asieldev/Fuzzy_Logic_Project/Prototipo.png

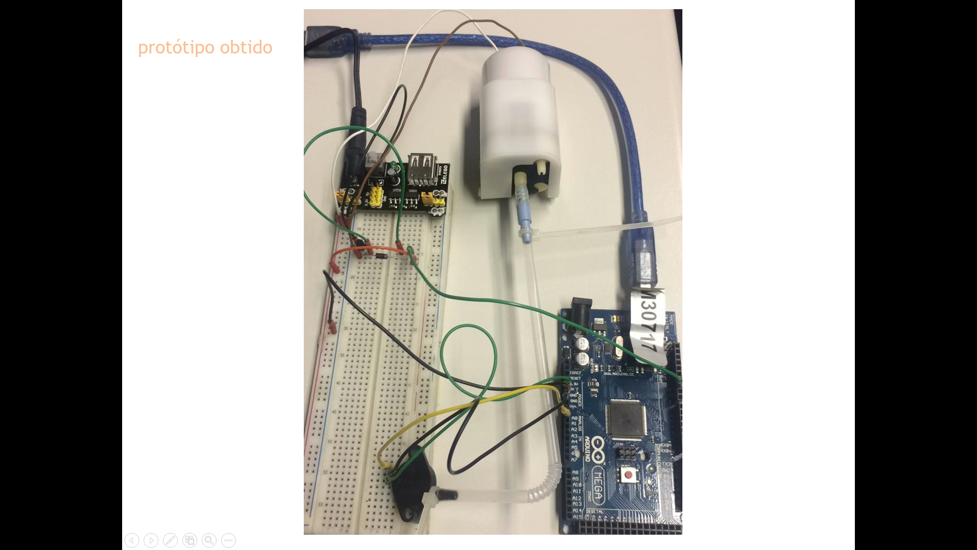
Prototipo.png
