asieldev/Fuzzy_Logic_Project/Code_Arduino/Proto.jpeg

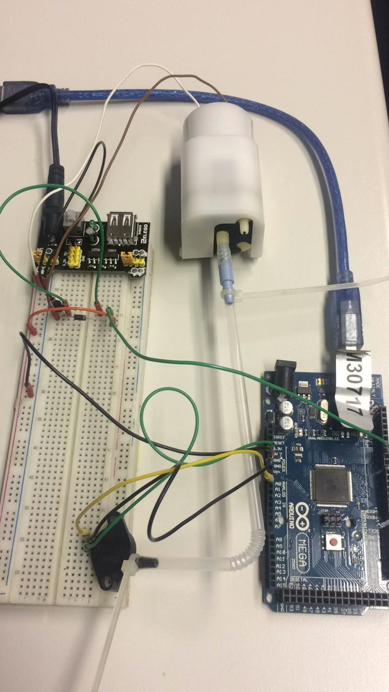
Code_Arduino/Proto.jpeg
