asieldev/Fuzzy_Logic_Project/README.md

# FuzzyLogic_Project
###  por Asiel Aldana Ortiz 

Este trabalho apresenta um controlador fuzzy capaz de realizar a inflação automática de uma faixa elástica que permita alcançar os níveis de pressão de referência com o menor erro de convergência possível, além de garantir que os tempos de convergência estejam dentro da faixa permitida pelos padrões internacionais para dispositivos médicos comerciais que empregam método oscilométrico para medição não invasiva da pressão arterial, Além de a implentação do controlador fuzzy no microcontrolador ATmega2560, foi desenvolvido uma  interface gráfica do usuário (GUI em Delphi_10.3_Rio) para assegurar o controle e visualização do sinal de pressão obtida da leitura do canal de medição analógico do microcontrolador antes mencionado. A sinal analógica de pressão é medida pelo sensor de pressão MPX5050GP. O modelo fuzzy gera em sua saída um valor preciso proporcional à largura do pulso com o qual a micro-Pump de ar será excitada para obter o nível de pressão desejado na saída.
