asieldev/Fuzzy_Logic_Project/Code_Arduino/Fuzzy_FILE_Asiel.rtf

General Information

Audit Log
2019-07-07 12:55:45 | asiel | 8.21c | FT 10005 28 HS | Last Edit
2019-07-02 02:20:31 | asiel | 8.21c | FT 10005 28 HS | Created

Documentation Created: domingo, 7 de julho de 2019
Edition Name: fuzzyTECH 8.21c Professional Edition
Table of Contents

List of Figures

List of Tables

List of Abbreviations

Compute MBF | Compute Membership Function (Fuzzification Method)
Fast CoA | Fast Center of Area (Defuzzification Method)
BSum | Bounded Sum Fuzzy Operator for Result Aggregation
Min | Fuzzy Operator for AND Aggregation
Max | Fuzzy Operator for OR Aggregation
Prod | Fuzzy Operator for Composition
LV | Linguistic Variable
MBF | Membership Function
RB | Rule Block

Fuzzy System

Project Description

Input Variables | 2
Output Variables | 1
Intermediate Variables | 0
Rule Blocks | 1
Rules | 15
Membership Functions | 12
Table 1: Project Statistics

System Structure

The system structure identifies the fuzzy logic inference flow from the input variables to the output variables. The fuzzification in the input interfaces translates analog inputs into fuzzy values. The fuzzy inference takes place in rule blocks which contain the linguistic control rules. The output of these rule blocks are linguistic variables. The defuzzification in the output interfaces translates them into analog variables.

The following figure shows the whole structure of this fuzzy system including input interfaces, rule blocks and output interfaces. The connecting lines symbolize the data flow.

Figure 1: Structure of the Fuzzy Logic System

Variables

This chapter contains the definition of all linguistic variables and of all membership functions.
Linguistic variables are used to translate real values into linguistic values. The possible values of a linguistic variable are not numbers but so called 'linguistic terms'.

The following tables list all variables of the system as well as the respective fuzzification or defuzzification method. Also the properties of all base variables and the term names are listed.

Inputs

# | Variable Name | Type | Unit | Min | Max | Default

1 | d_error | | | -1 | 1 | 0
2 | error | | | -300 | 300 | 0
Table 2: Variables of Group "Inputs"

Fuzzification Methods
Compute MBF

Outputs

# | Variable Name | Type | Unit | Min | Max | Default

3 | pwm_out | | | 0 | 255 | 0
Table 3: Variables of Group "Outputs"

Defuzzification Methods
Fast CoA

The default value of an output variable is used if no rule is firing for this variable. Different methods can be used for the defuzzification, resulting either in to the 'most plausible result' or the 'best compromise'.

The 'best compromise' is produced by the methods:
CoM (Center of Maximum)
CoA (Center of Area)
CoA BSUM, a version especially for efficient VLSI implementations

The 'most plausible result' is produced by the methods:
MoM (Mean of Maximum)
Categorical MoM (Categorical Mean of Maximum)
MoM BSUM, a version especially for efficient VLSI implementations

Input Variable "d_error"

Figure 2: MBF of "d_error"

Terms of Variable "d_error"

Term "d_neg"

Type: | Linear (Standard)
Definition Points: | (-1,00000|100) (-0,80000|100) (0,00000|0) (1,00000|0)
Inverse: | Off
Comment:

Term "d_ok"

Type: | Linear (Standard)
Definition Points: | (-1,00000|0) (-0,30000|0) (0,00000|100) (0,30000|0) (1,00000|0)
Inverse: | Off
Comment:

Term "d_pos"

Type: | Linear (Standard)
Definition Points: | (-1,00000|0) (0,00000|0) (0,80000|100) (1,00000|100)
Inverse: | Off
Comment:

Input Variable "error"

Figure 3: MBF of "error"

Terms of Variable "error"

Term "alto_neg"

Type: | Linear (Standard)
Definition Points: | (-300,00|100) (-250,00|100) (-50,00|0) (0,00|0) (300,00|0)
Inverse: | Off
Comment:

Term "medio_neg"

Type: | Linear (Standard)
Definition Points: | (-300,00|0) (-100,00|0) (-50,00|100) (0,00|0) (300,00|0)
Inverse: | Off
Comment:

Term "ok"

Type: | Linear (Standard)
Definition Points: | (-300,00|0) (-50,00|0) (0,00|100) (50,00|0) (300,00|0)
Inverse: | Off
Comment:

Term "medio_pos"

Type: | Linear (Standard)
Definition Points: | (-300,00|0) (0,00|0) (50,00|100) (100,00|0) (300,00|0)
Inverse: | Off
Comment:

Term "alto_pos"

Type: | Linear (Standard)
Definition Points: | (-300,00|0) (0,00|0) (50,00|0) (250,00|100) (300,00|100)
Inverse: | Off
Comment:

Output Variable "pwm_out"

Figure 4: MBF of "pwm_out"

Terms of Variable "pwm_out"

Term "pwm_zero"

Type: | Linear (Standard)
Definition Points: | (0,000|100) (2,000|100) (40,000|0) (255,000|0)
Comment:

Term "pwm_bajo"

Type: | Linear (Standard)
Definition Points: | (0,000|0) (20,000|0) (60,000|100) (100,000|0) (255,000|0)
Comment:

Term "pwm_medio"

Type: | Linear (Standard)
Definition Points: | (0,000|0) (80,000|0) (120,000|100) (160,000|0) (255,000|0)
Comment:

Term "pwm_alto"

Type: | Linear (Standard)
Definition Points: | (0,000|0) (140,000|0) (200,000|100) (255,000|100)
Comment:

Rule Blocks

The rule blocks contain the control strategy of a fuzzy logic system. Each rule block confines all rules for the same context. A context is defined by the same input and output variables of the rules.

The rules' 'if' part describes the situation, for which the rules are designed. The 'then' part describes the response of the fuzzy system in this situation. The degree of support (DoS) is used to weigh each rule according to its importance.

The processing of the rules starts with calculating the 'if' part. The operator type of the rule block determines which method is used. The operator types MIN-MAX, MIN-AVG and GAMMA are available. The characteristic of each operator type is influenced by an additional parameter.

For example:

MIN-MAX, parameter value 0 = Minimum Operator (MIN)
MIN-MAX, parameter value 1 = Maximum Operator (MAX)
GAMMA, parameter value 0 = Product Operator (PROD)

The minimum operator is a generalization of the Boolean 'and'; the maximum operator is a generalization of the Boolean 'or'.

The fuzzy composition eventually combines the different rules to one conclusion. If the BSUM method is used all firing rules are evaluated, if the MAX method is used only the dominant rules are evaluated.

Rule Block "RB1"

Input Aggregation: | Min
Result Aggregation: | Max
Number of Inputs: | 2
Number of Outputs: | 1
Number of Rules: | 15
Comment:
Color: | Default
Deactivation: | Off
Protection: | Off
GUID: | 7DEE4B1E-A46E-435F-AA06-B56DF9874BF9

Rule Group

Number of Rules: | 15
Comment:
Color: | Default
Deactivation: | Off
Protection: | Off
GUID: | 1B8908AF-63B8-464C-A887-546C7D04ABD9

Rule

Number of Rules: | 1
Comment:
Color: | Default
Deactivation: | Off
Protection: | Off
GUID: | 0E535615-8ACA-4875-BA54-561ACF44E7B4

d_error.d_ok & error.ok => pwm_out.pwm_zero with 100

Rule

Number of Rules: | 1
Comment:
Color: | Default
Deactivation: | Off
Protection: | Off
GUID: | BF0BCF48-3399-4D9F-96B7-05E60D73EF93

d_error.d_pos & error.ok => pwm_out.pwm_bajo with 100

Rule

Number of Rules: | 1
Comment:
Color: | Default
Deactivation: | Off
Protection: | Off
GUID: | 3FFBBA6A-C12C-41D0-923B-F194D03C67F6

d_error.d_neg & error.ok => pwm_out.pwm_bajo with 100

Rule

Number of Rules: | 1
Comment:
Color: | Default
Deactivation: | Off
Protection: | Off
GUID: | E0B96919-ADC3-433D-B43C-645749595862

d_error.d_ok & error.medio_pos => pwm_out.pwm_medio with 100

Rule

Number of Rules: | 1
Comment:
Color: | Default
Deactivation: | Off
Protection: | Off
GUID: | D77FE709-A8C2-412C-A9E2-85DFACECDE9A

d_error.d_pos & error.medio_pos => pwm_out.pwm_medio with 100

Rule

Number of Rules: | 1
Comment:
Color: | Default
Deactivation: | Off
Protection: | Off
GUID: | 9F48C289-89DC-496A-AED7-43C349745349

d_error.d_neg & error.medio_pos => pwm_out.pwm_medio with 100

Rule

Number of Rules: | 1
Comment:
Color: | Default
Deactivation: | Off
Protection: | Off
GUID: | 996EB08F-320E-4774-A6EF-AF46B29F5181

d_error.d_ok & error.alto_pos => pwm_out.pwm_alto with 100

Rule

Number of Rules: | 1
Comment:
Color: | Default
Deactivation: | Off
Protection: | Off
GUID: | 3CD51256-67CC-4600-ACCE-0580F2098630

d_error.d_pos & error.alto_pos => pwm_out.pwm_alto with 100

Rule

Number of Rules: | 1
Comment:
Color: | Default
Deactivation: | Off
Protection: | Off
GUID: | 05E94ABD-8A74-4A46-A2FF-CFE0D0B624F4

d_error.d_neg & error.alto_pos => pwm_out.pwm_alto with 100

Rule

Number of Rules: | 1
Comment:
Color: | Default
Deactivation: | Off
Protection: | Off
GUID: | 2FC4646D-BF0F-4398-85E7-C80A2D7219FF

d_error.d_ok & error.medio_neg => pwm_out.pwm_zero with 100

Rule

Number of Rules: | 1
Comment:
Color: | Default
Deactivation: | Off
Protection: | Off
GUID: | A82206BE-C9B9-4772-BBEA-4457A3E3008E

d_error.d_pos & error.medio_neg => pwm_out.pwm_zero with 100

Rule

Number of Rules: | 1
Comment:
Color: | Default
Deactivation: | Off
Protection: | Off
GUID: | 9A5E9EB9-5DFA-4838-A5D3-7803BC201449

d_error.d_neg & error.medio_neg => pwm_out.pwm_zero with 100

Rule

Number of Rules: | 1
Comment:
Color: | Default
Deactivation: | Off
Protection: | Off
GUID: | C591705B-B290-45B8-A1D5-43D3BCAB4EF9

d_error.d_ok & error.alto_neg => pwm_out.pwm_zero with 100

Rule

Number of Rules: | 1
Comment:
Color: | Default
Deactivation: | Off
Protection: | Off
GUID: | 98D0245C-E8C5-467C-BF2D-946F9068783B

d_error.d_pos & error.alto_neg => pwm_out.pwm_zero with 100

Rule

Number of Rules: | 1
Comment:
Color: | Default
Deactivation: | Off
Protection: | Off
GUID: | DFAB87AE-69EE-4AAA-AEF8-094C47004000

d_error.d_neg & error.alto_neg => pwm_out.pwm_zero with 100
