asieldev/Fuzzy_Logic_Project/Slides_Project.pdf

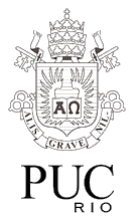
[picture p14: figure]

# Implementação de um controle difuso para a inflação automática de uma banda elástica em um módulo de medição não invasivo da pressão

arterial.

# Fuzzy Logic

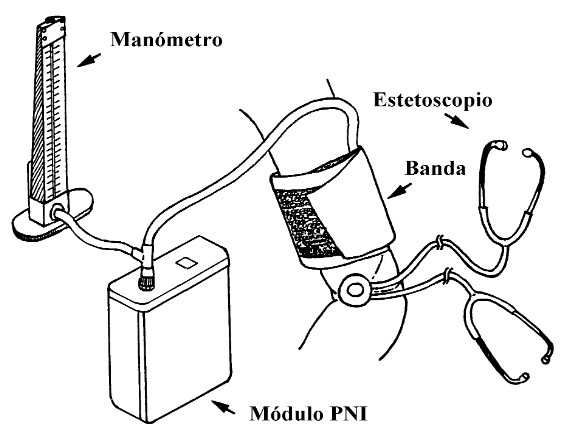
[picture p15: figure]

## Asiel Aldana Ortiz

# - Aumento exponencial de doenças associadas à hipotensão e

hipertensão arterial.

# - A necessidade de dispor de um sistema de controle mais amigável

com o paciente, para a medição não invasiva da pressão arterial.

# Motivação:

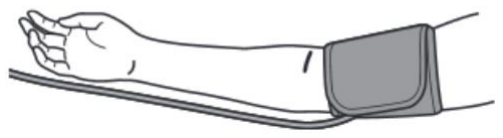
[picture p16: figure]

# - Implemente um controlador difuso para a fase de inflação em um módulo de medição não invasiva da

pressão arterial.

# Objetivo:

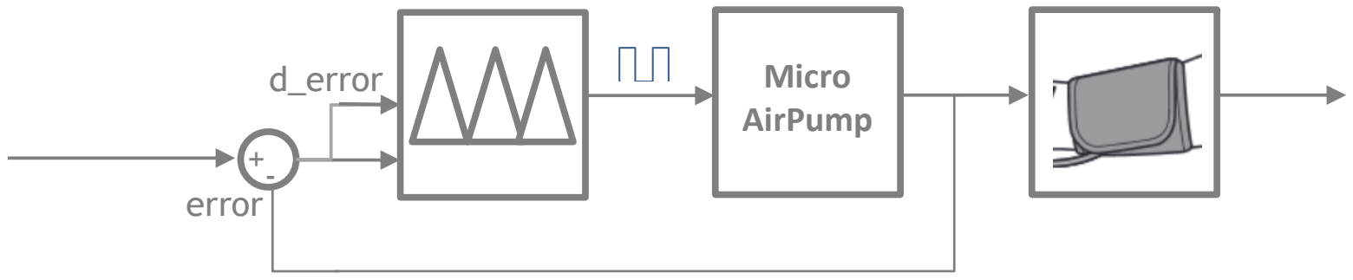
[picture p17: figure]
Micro AirPump; error; d_error

### Pres_Ref

- Não invasivo.
- Cálculo efetivo da pressão média(Pm).

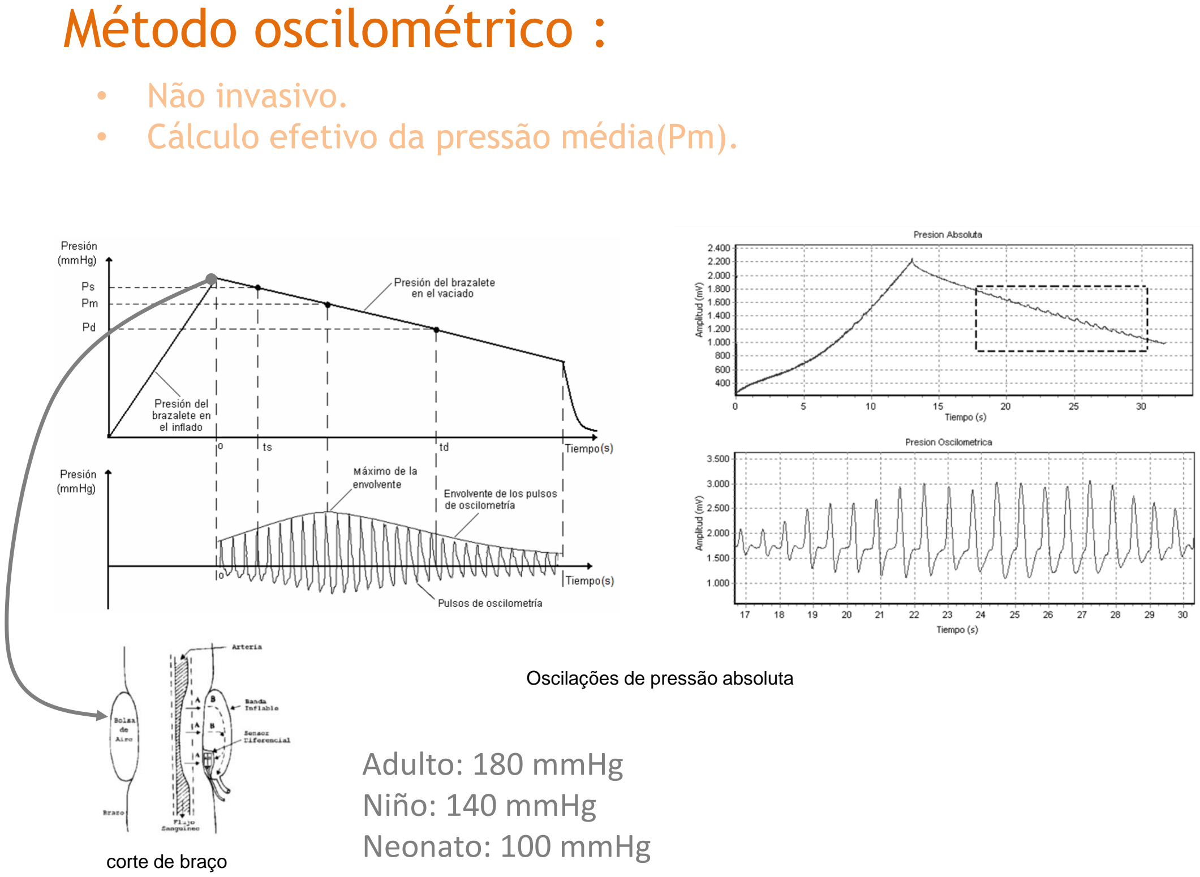
[picture p18: page 4]

# Método oscilométrico :

### Oscilações de pressão absoluta

### corte de braço

# Adulto: 180 mmHg Niño: 140 mmHg Neonato: 100 mmHg

# A metodologia de trabalho foi dividida em 4 etapas:

1. Modelagem de controlador fuzzy.

# 2. Implementação do modelo difuso no micro-controlador

ATMEGA2560, mais Protótipo obtido.

# 3. Implementação da interface gráfica do usuário(GUI) para o

controle e visualização do sinal de pressão obtida.

4. Resultados obtidos.

# Metodologia:

# Modelagem da Proposta(FuzzyTech)

1

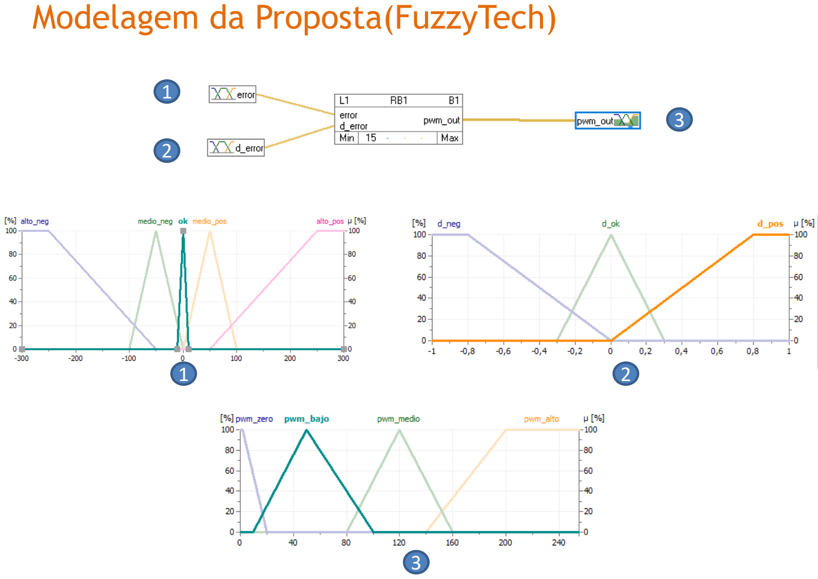
[picture p19: page 6]

2

3

3

1 | 2

# Implementação do modelo difuso no ATMEGA2560:

# eFLL (Embedded Fuzzy Logic Library)

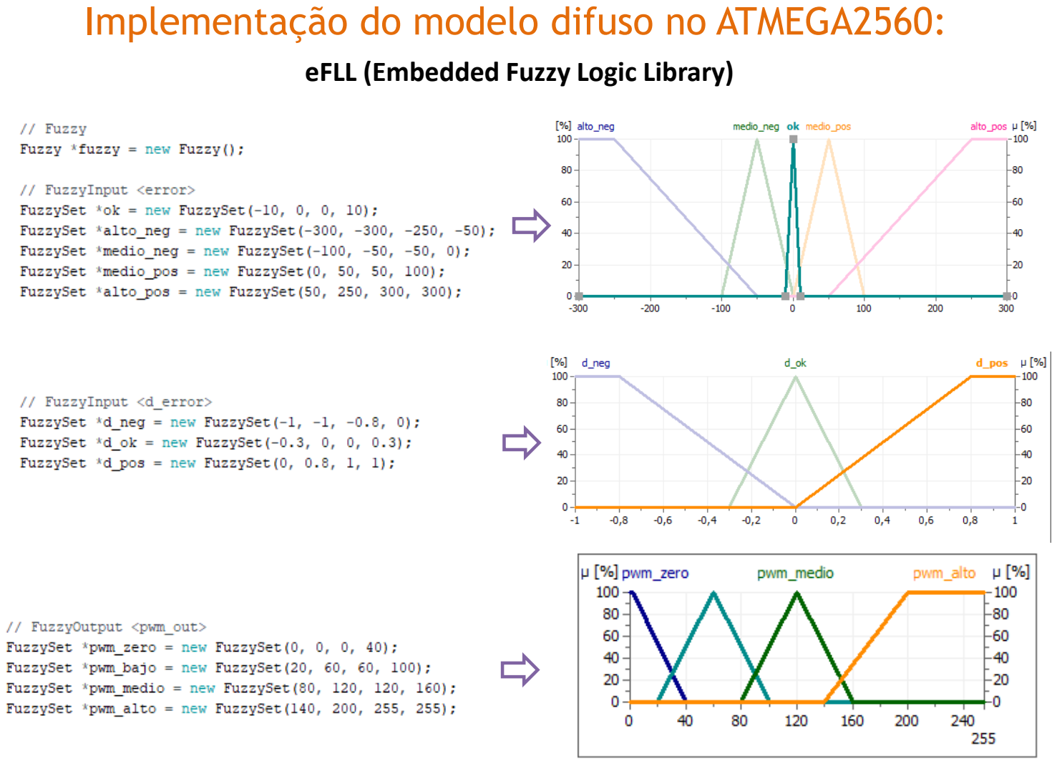
[picture p20: page 7]

# Implementação do modelo difuso no ATMEGA2560:

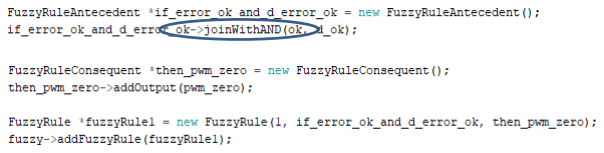
[picture p21: figure]

# Implicação Agregação

Min | Max
| Fast CoA

# Regras:

1. d_error.d_ok & error.ok => pwm_out.pwm_zero.
2. d_error.d_pos & error.ok => pwm_out.pwm.
3. d_error.d_neg & error.ok => pwm_out.pwm_bajo.
4. d_error.d_ok & error.medio_pos => pwm_out.pwm_medio.
5. d_error.d_pos & error.medio_pos => pwm_out.pwm_medio.

### 6. d_error.d_neg & error.medio_pos => pwm_out.pwm_medio

7. d_error.d_ok & error.alto_pos => pwm_out.pwm_alto
8. d_error.d_pos & error.alto_pos => pwm_out.pwm_alto
9. d_error.d_neg & error.alto_pos => pwm_out.pwm_alto
10. d_error.d_ok & error.medio_neg => pwm_out.pwm_zero
11. d_error.d_pos & error.medio_neg => pwm_out.pwm_zero
12. d_error.d_neg & error.medio_neg => pwm_out.pwm_zero
13. d_error.d_ok & error.alto_neg => pwm_out.pwm_zero
14. d_error.d_pos & error.alto_neg => pwm_out.pwm
15. d_error.d_neg & error.alto_neg => pwm_out.pwm_zero

# Esquemático do protótipo obtido:

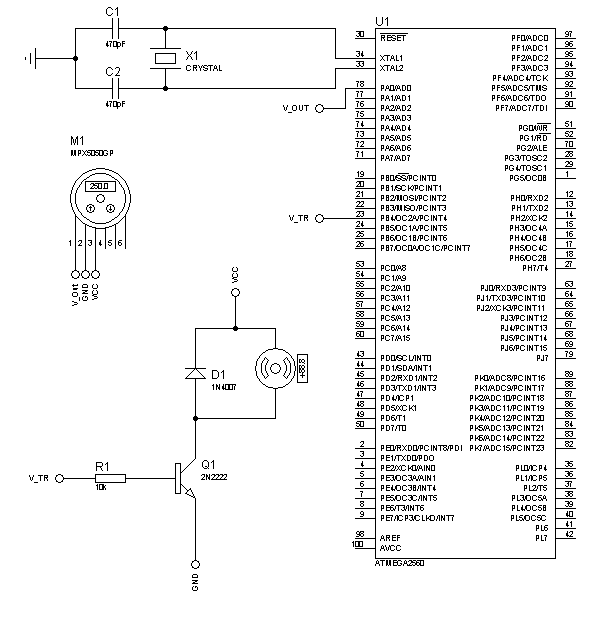
[picture p22: figure]

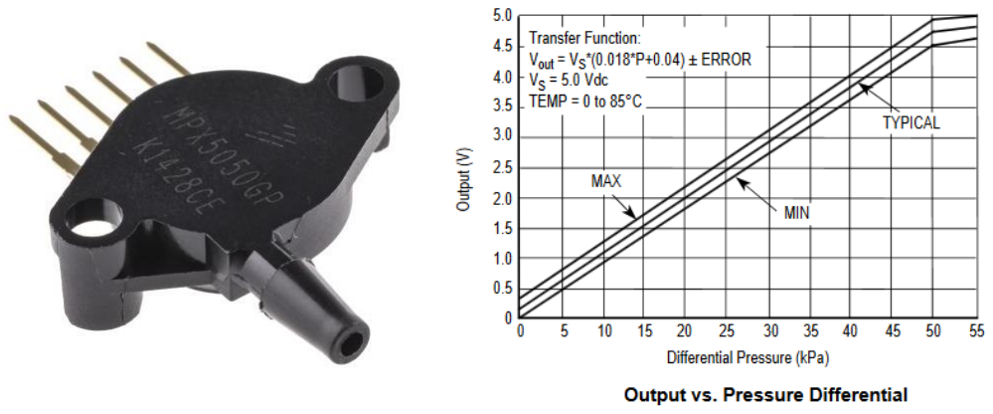
[picture p23: figure]

### Sensor de pressão MPX5050GP

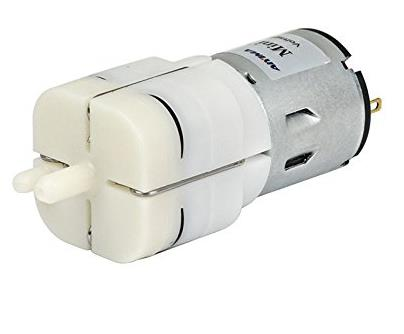
[picture p24: figure]

### Micro-AirPump

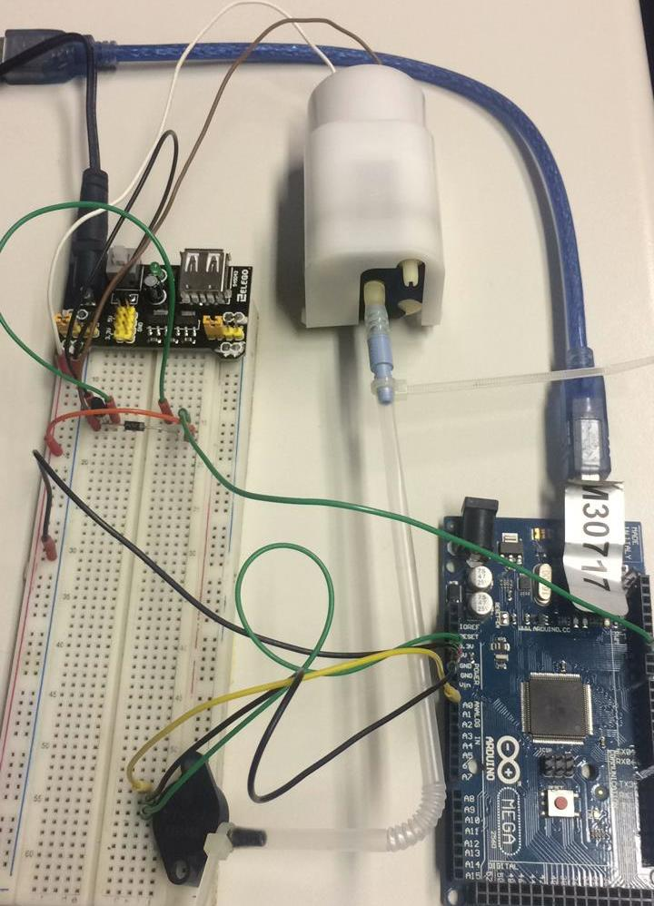
[picture p25: figure]

# protótipo obtido

# Interface gráfica do usuário(GUI) desenvolvida(Object Pascal - Delphi)

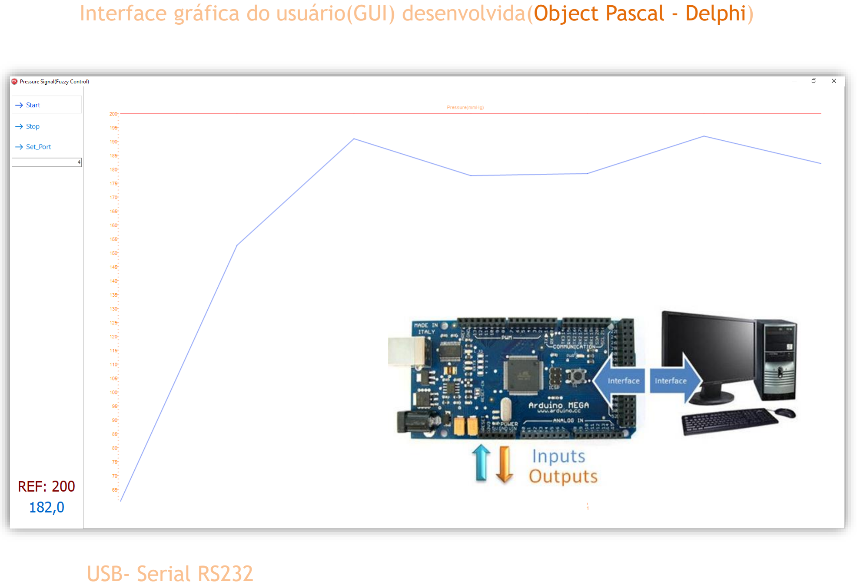
[picture p26: page 14]

# USB- Serial RS232

# Resultados

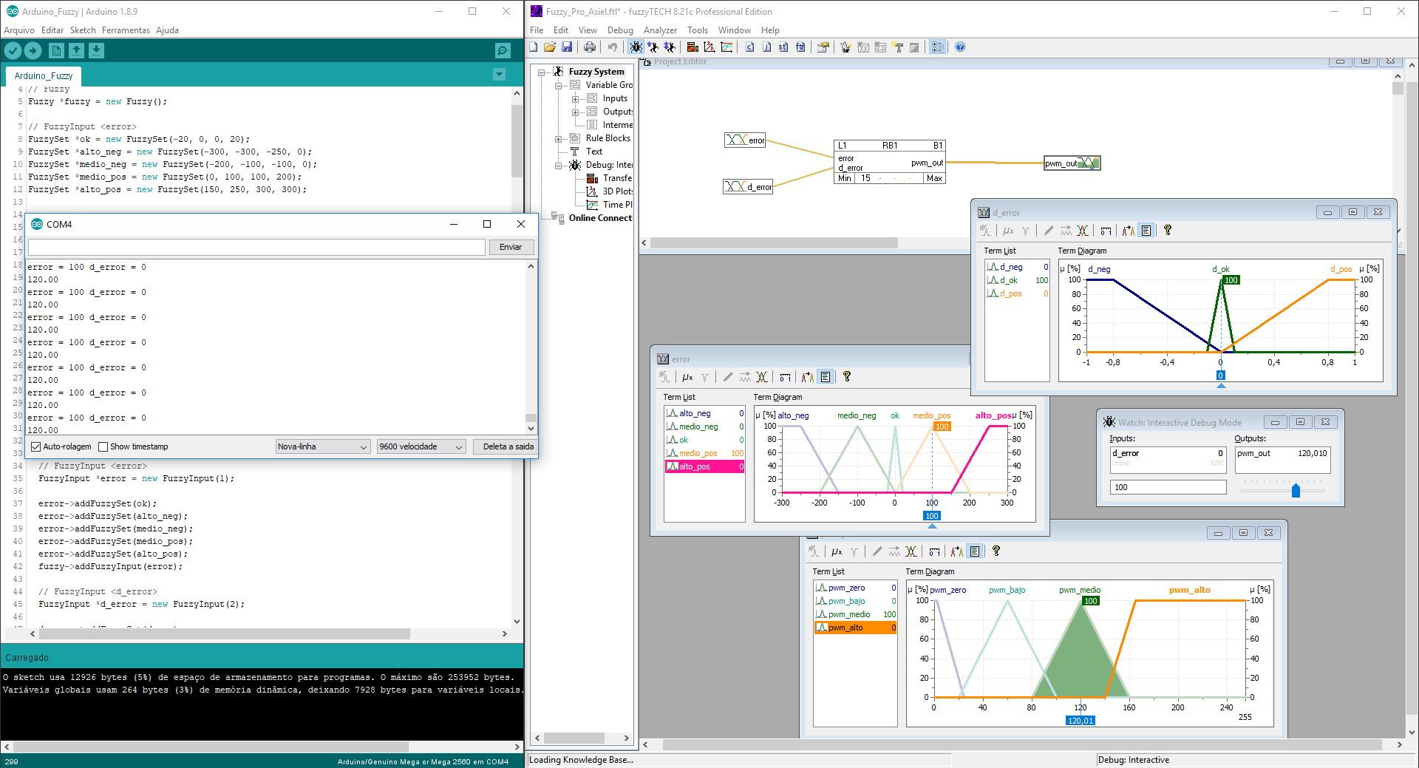
[picture p27: page 15]

# Erro de ajuste

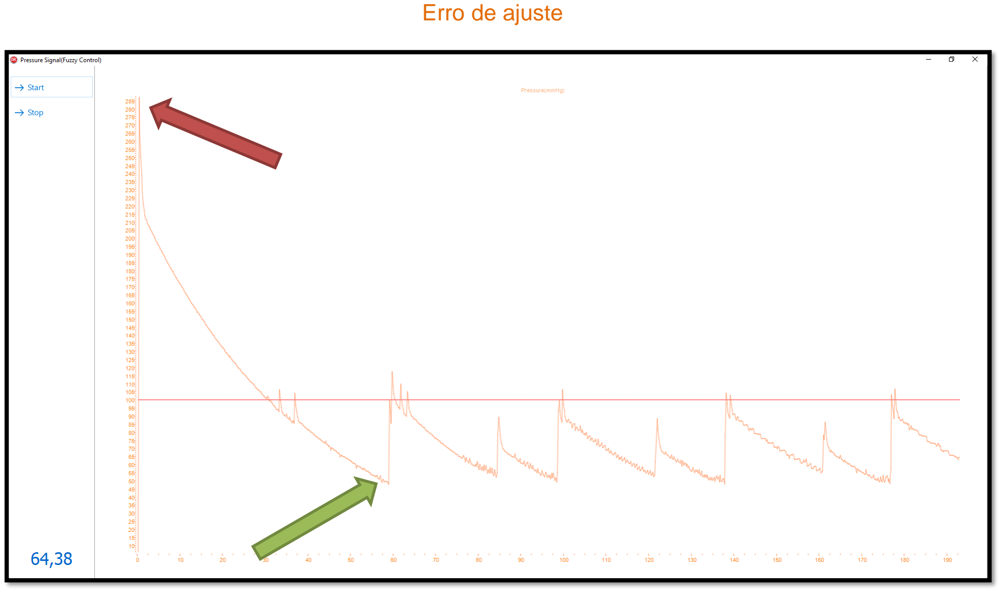
[picture p28: page 16]

# Erro de ajuste

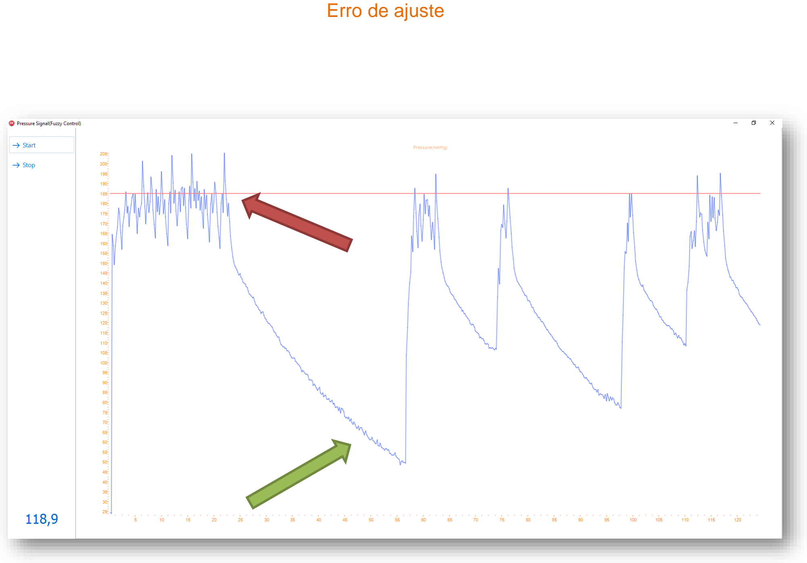
[picture p29: page 17]

# Erro de ajuste

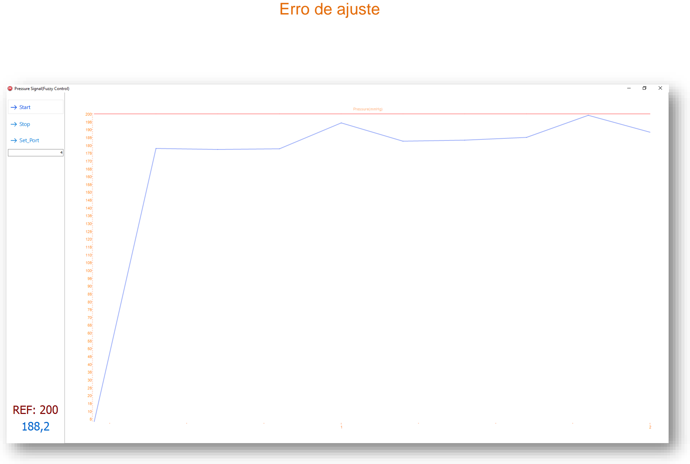
[picture p30: page 18]

# Erro de ajuste

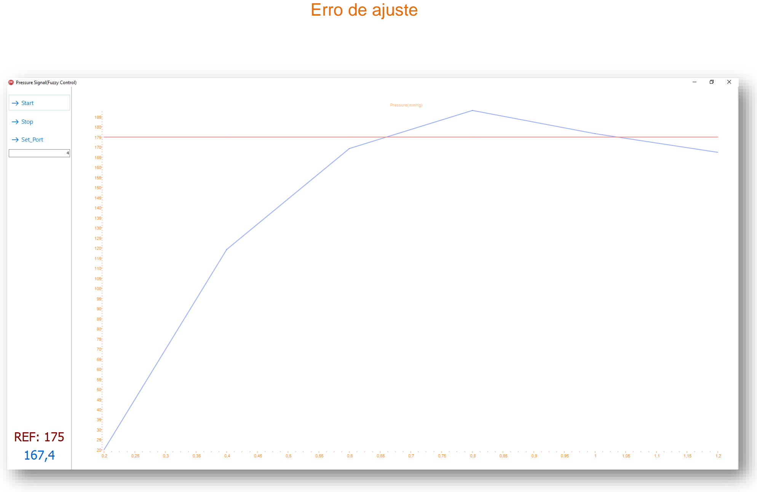
[picture p31: page 19]

# Conclusões:

# Com o presente trabalho foi possível modelar um protótipo físico para o controle da inflação de uma

pulseira elástica, utilizando técnicas de controle fuzzy.

# - Embora a precisão não tenha sido a ideal para a aplicação médica proposta, foi possível verificar a eficácia de modelos fuzzy na solução de problemas semelhantes

# Obrigado!!!
