asieldev/Fuzzy_Logic_Project/Code_Arduino/SIMULA.bmp

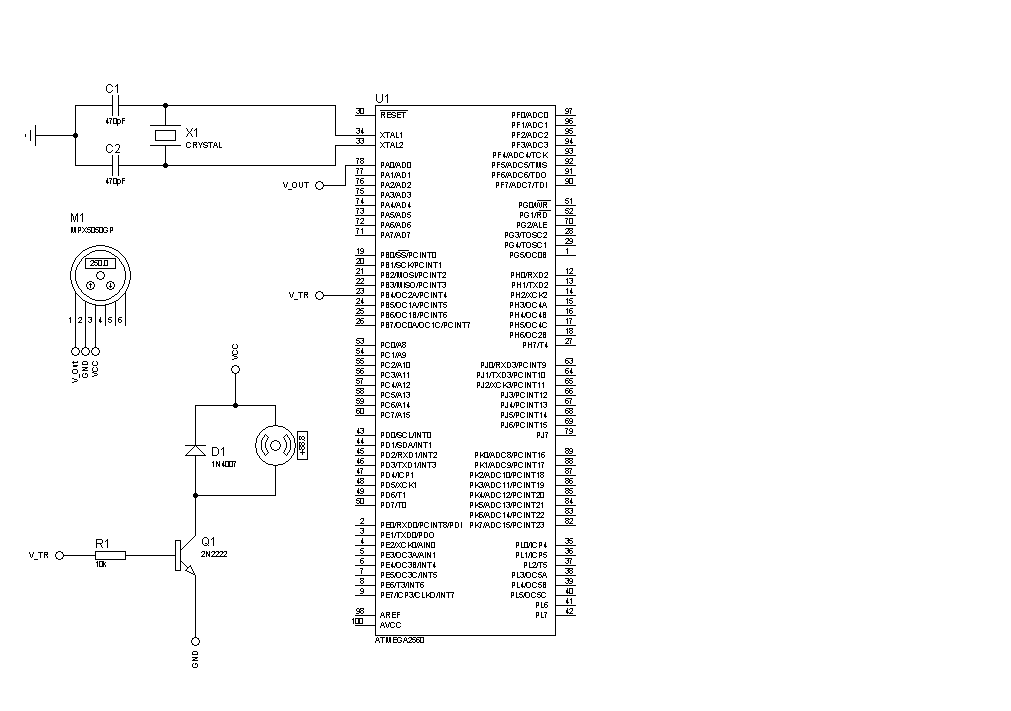
Code_Arduino/SIMULA.bmp
