asieldev/Fuzzy_Logic_Project/Interface_0.png

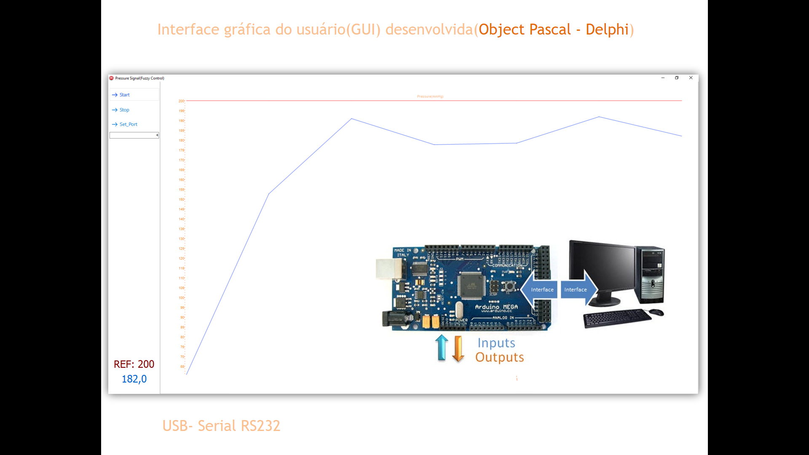
Interface_0.png
